lipoyang/Pendolino4/images/back.jpg

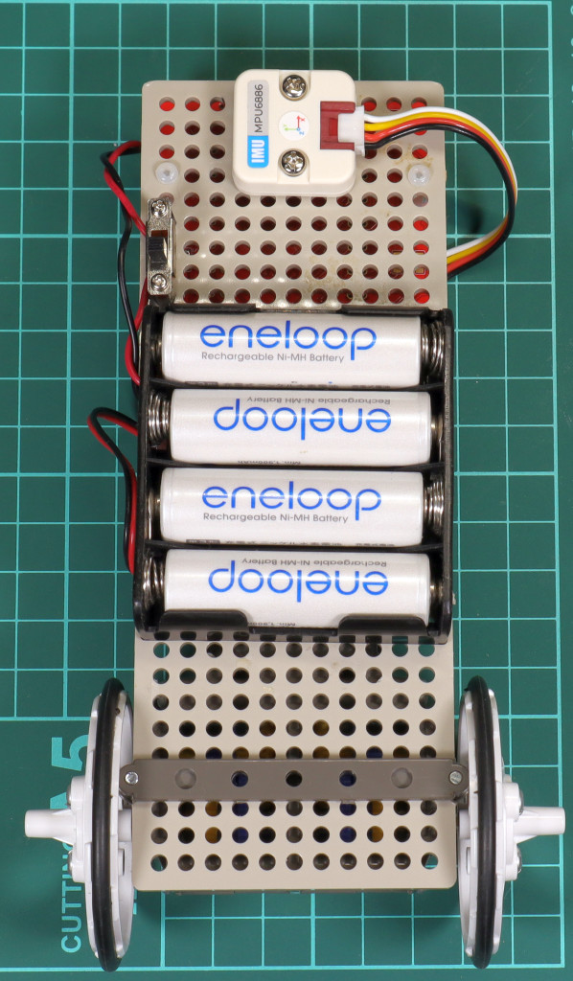
images/back.jpg
