lipoyang/Pendolino4/images/front.jpg

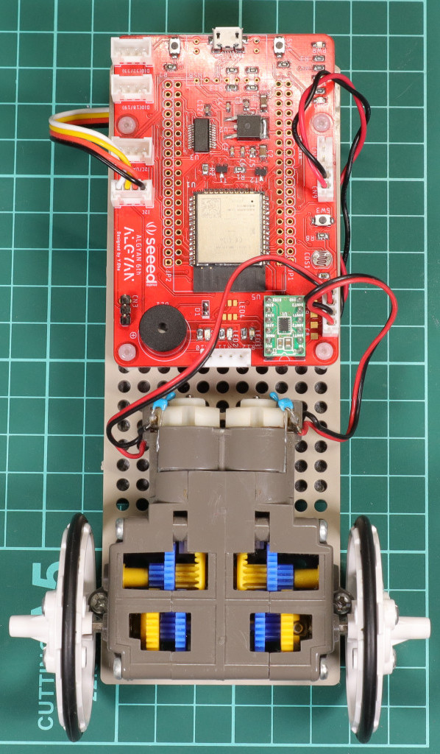
images/front.jpg
